Samuel-eng404/SafeLink./Parent-Bracelet-Schematic.pdf

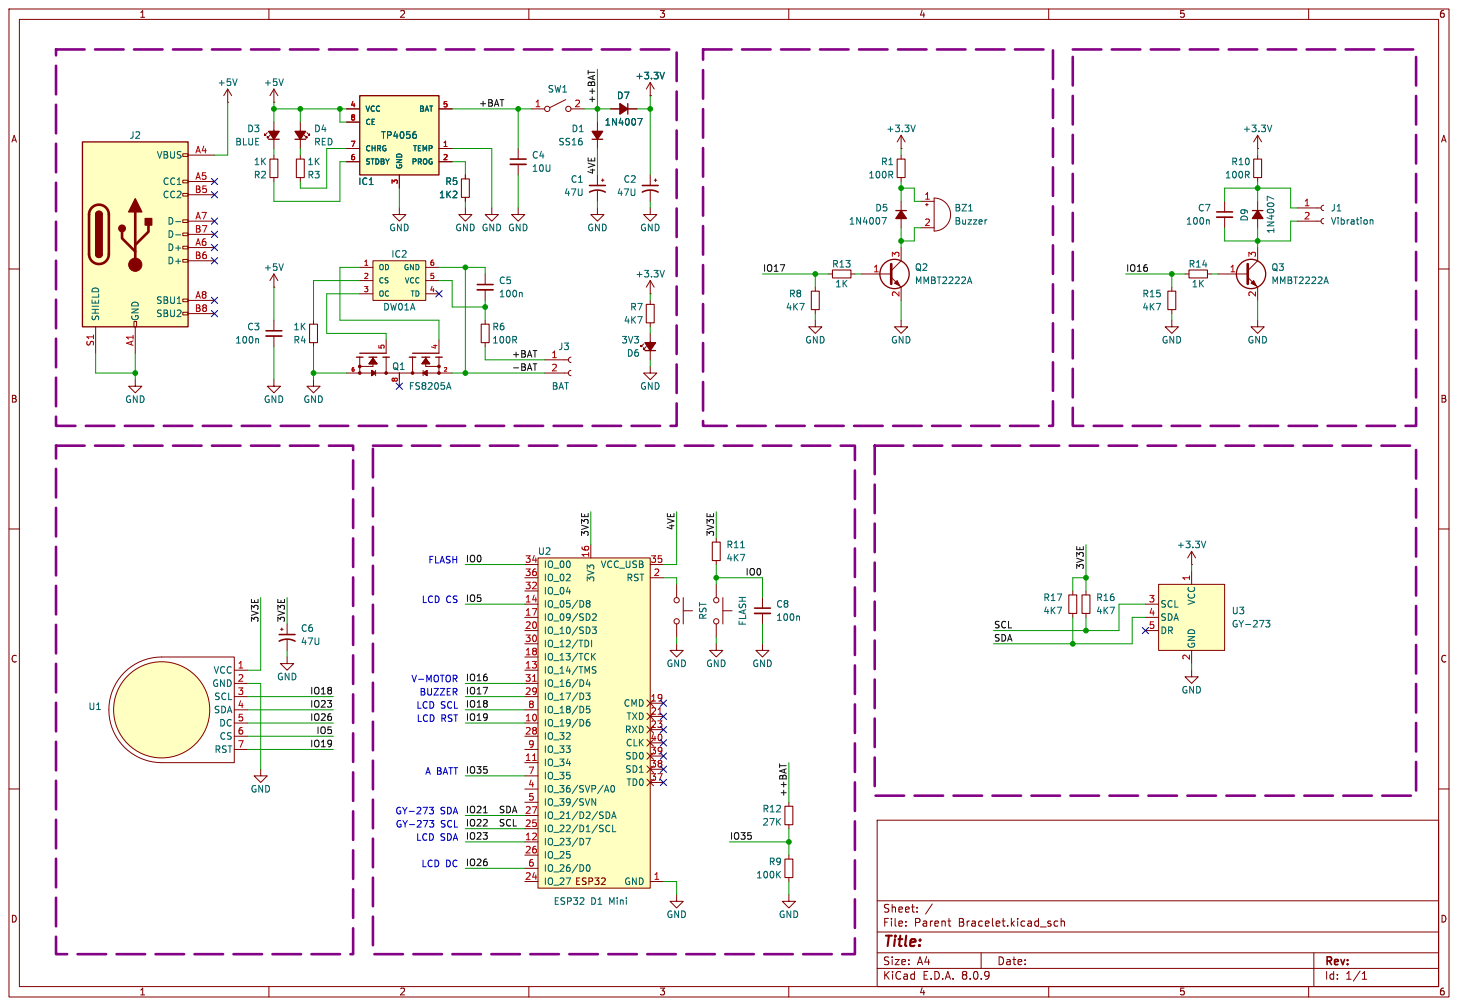
[picture p62: page 1]

3 VCC 4 BAT 5 STDBY 6 CHRG 7 CE 8 +3.3V D7

3 VCC 4 BAT 5 STDBY 6 CHRG 7 CE 8

2 SCL 3 SDA 4 DR 5 U3 GY-273 4VE 3V3E ++BAT
BUZZER
LCD SCL
LCD RST
