Samuel-eng404/SafeLink./Child-Bracelet-Schematic.pdf

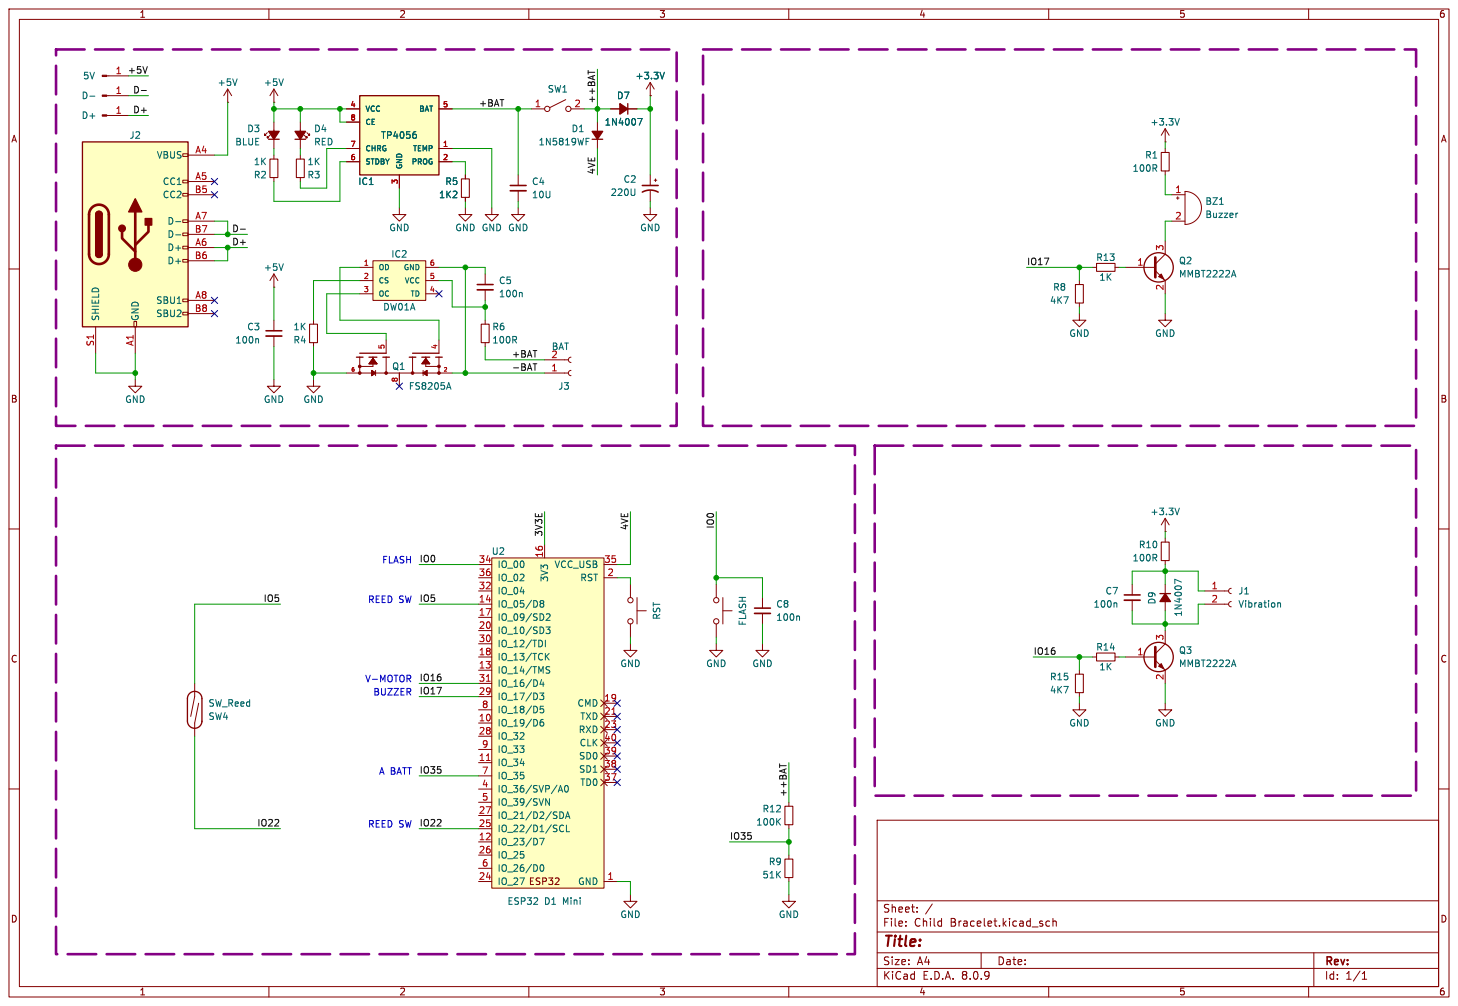
[picture p63: page 1]
